niccolli/GBPCB/docs/images/usb.jpg

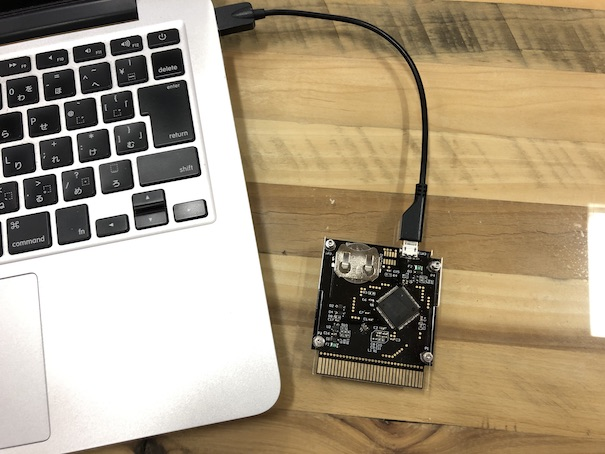
docs/images/usb.jpg
