niccolli/GBPCB/docs/images/usage.jpg

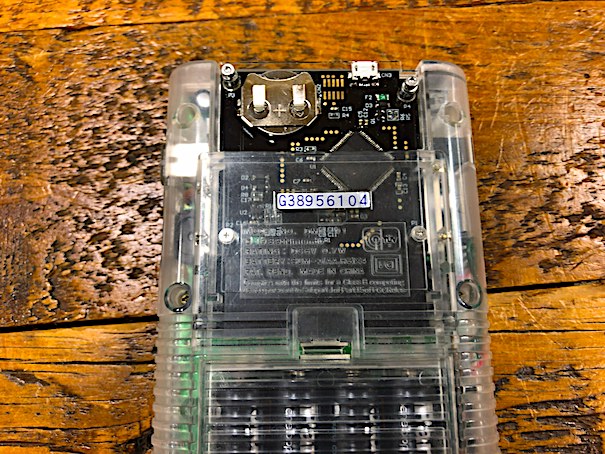
docs/images/usage.jpg
