niccolli/GBPCB/(commit log)

2019-05-28 tools: ファイルをつくってヘルプメッセージだけ表示できるようにした
2019-05-28 tools: 引数に合わせた分岐をつくった
2019-05-28 tools: 引数が足りないときもヘルプメッセージを表示するよう分岐
2019-05-28 tools: 各引数ごとのdfu-utilを記載
2019-05-29 tools: オプションの説明を記載
2019-06-08 とりあえずmacOSの一時ファイルを定義したgitignoreを作成
2019-06-08 ページ内で使う画像を作成
2019-06-08 本文をテストから初稿に変更
2019-06-08 niccol.liで表示できなかったのでURLを変更
2019-06-08 ページに機能・制限・注意まで記載
2019-06-09 USBケーブル接続時の画像を追加
2019-06-09 バッテリーバックアップに電池の情報を追加
2019-06-10 使い方を少し書いた
2019-06-10 macOS/Linux用のツール説明を追加
2019-06-10 謝辞を追加
2019-06-11 MBCファームウェアを追加
2019-06-11 書き換え時のコイン電池の注意書きを追加
2019-06-11 制限に4MHzの旨追加
2019-06-11 Windowsでドライバ入れ替えについて記載
2019-06-11 Windows用の書き込みスクリプトを作成
2019-06-11 Windowsでの書き換え方法を追加
2019-06-11 注意書きを追加
2019-06-16 dfu-utilのバージョンとGBAの注意を追加
2019-08-13 Add PCB Schematics and Gerber files.
    [GBPCB.GBL, GBPCB.GBO, GBPCB.GBS, GBPCB.GTL, GBPCB.GTO, GBPCB.GTS]
